Divisekara/Digital-Line-Follower-PIC16F877A/lab project files/project report/IMG-20181125-WA0025.jpg

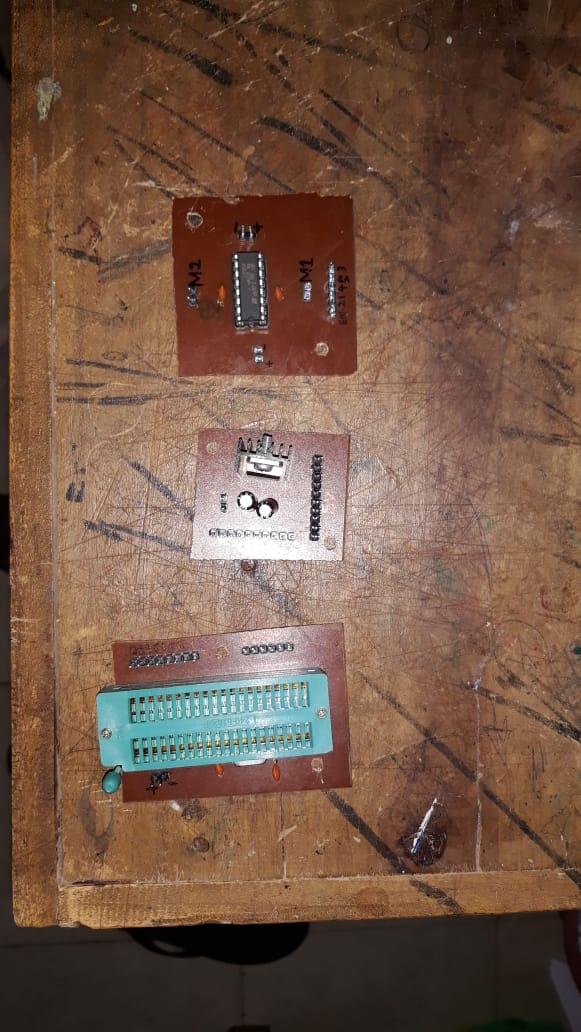
lab project files/project report/IMG-20181125-WA0025.jpg
