Divisekara/Digital-Line-Follower-PIC16F877A/lab project files/project report/IMG-20181129-WA0038.jpg

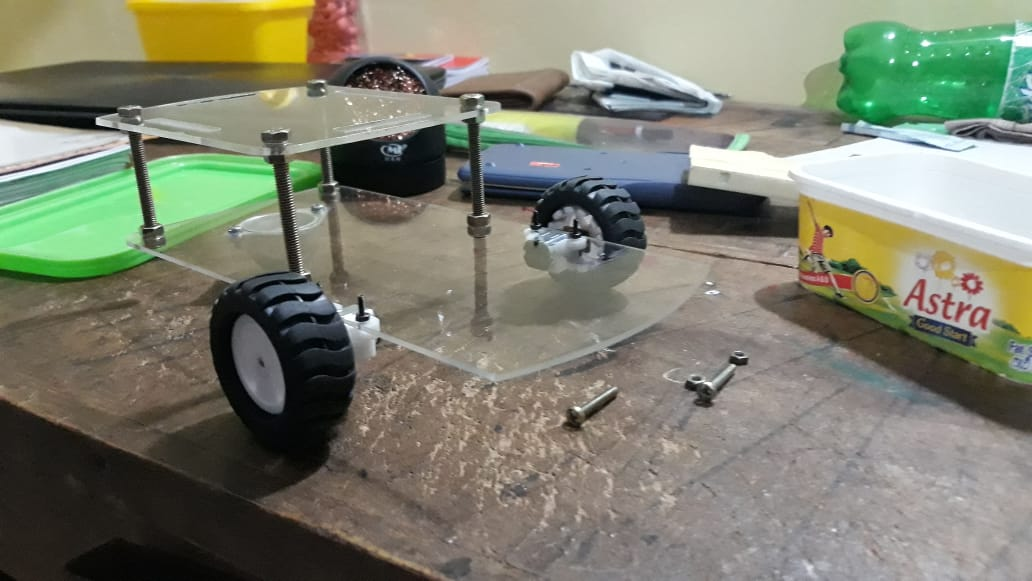
lab project files/project report/IMG-20181129-WA0038.jpg
