Divisekara/Digital-Line-Follower-PIC16F877A/README.md

# Digital Line Follower-PIC16F877A
 Digital Line follower was meade of as simple as possinle using custome made PCBs on our own.  Using micro C software we programmed the PIC16F877A.
