Divisekara/Digital-Line-Follower-PIC16F877A/lab report/Top part.pdf

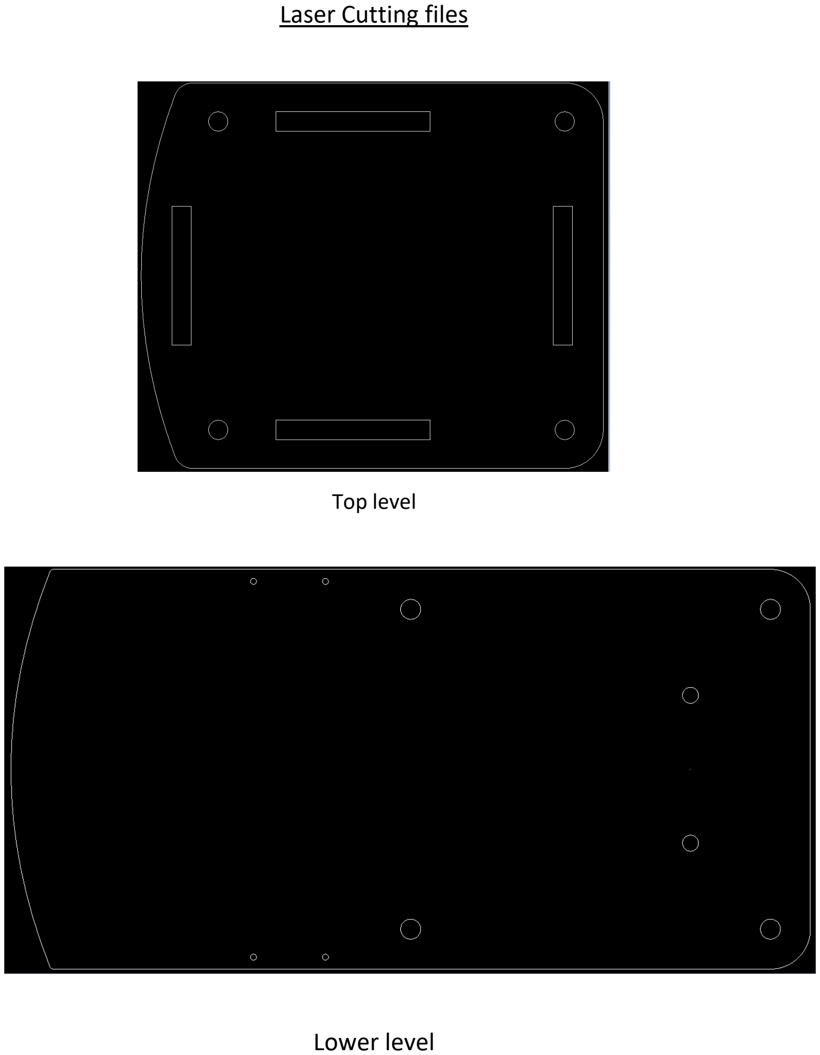
[picture p43: page 1]

Laser Cutting files

Top level

Lower level

Solidworks Designs

1. Lower Level

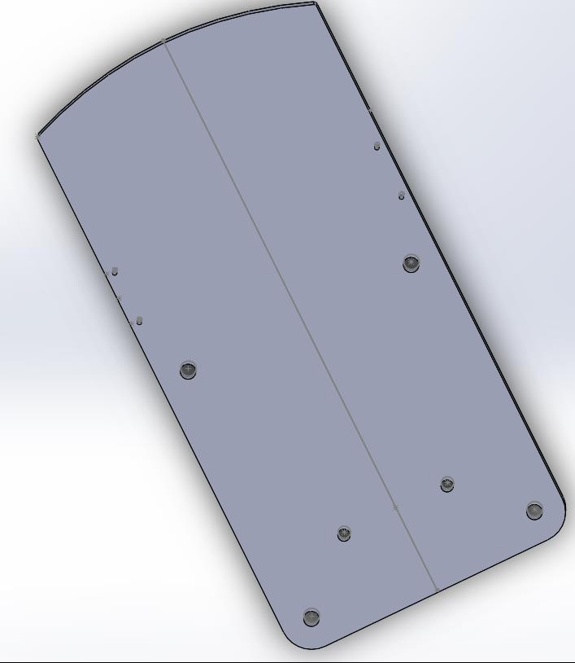
[picture p44: figure]

2. Top level

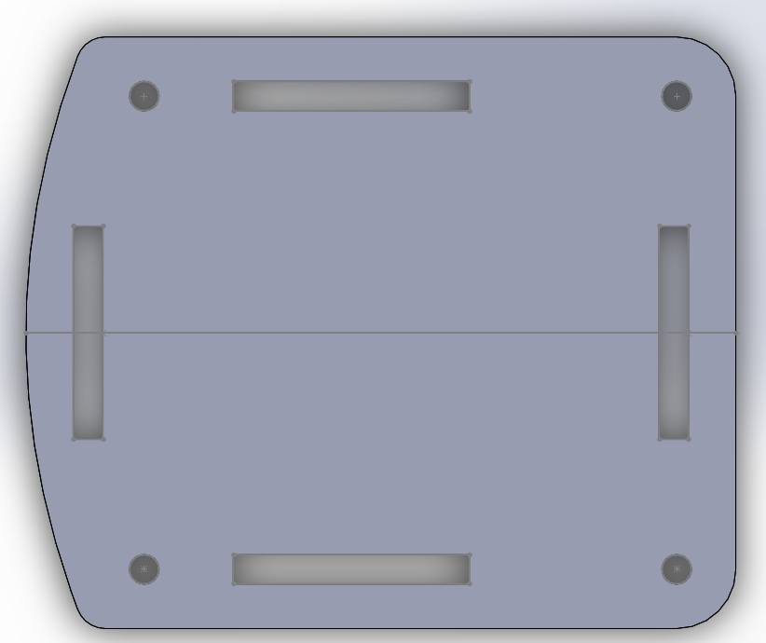
[picture p45: figure]
