Divisekara/Digital-Line-Follower-PIC16F877A/lab project files/weekly plan.pdf

### Team Members

Name | Index No
W.S.D. Fernando | 170168K | Mechanics and hardwork
D.M.D.P. Dissanayake | 170147V | Programming the PIC micro controller PCB designs
G. Gajanan | 170170J
D.M.A.I.Divisekara | 170150A

### Allocated work

Task
| 15 | 16 | 17 | 18 | 19 | 20 | 21 | 22 | 23 | 24 | 25 | 26 | 27 | 28 | 29 | 30
Making the schematic diagrams | Sensors
| Motor controllers
| Micro controller and power supply
Designing the enclosure using solid works
Making the layouts of the pcb | Sensors
| Motor controllers
| Micro controller and power supply
Programming PIC
Making PCBs | Sensors
| Motor controllers
| Micro controller and power supply
Testing the PCBs | Sensors
| Motor controllers
| Micro controller and power supply
Making enclosure
Assembling Components
Testing

### WEEKLY PLAN

Week one | Week two
