Divisekara/Digital-Line-Follower-PIC16F877A/lab project files/waas,asitha.docx

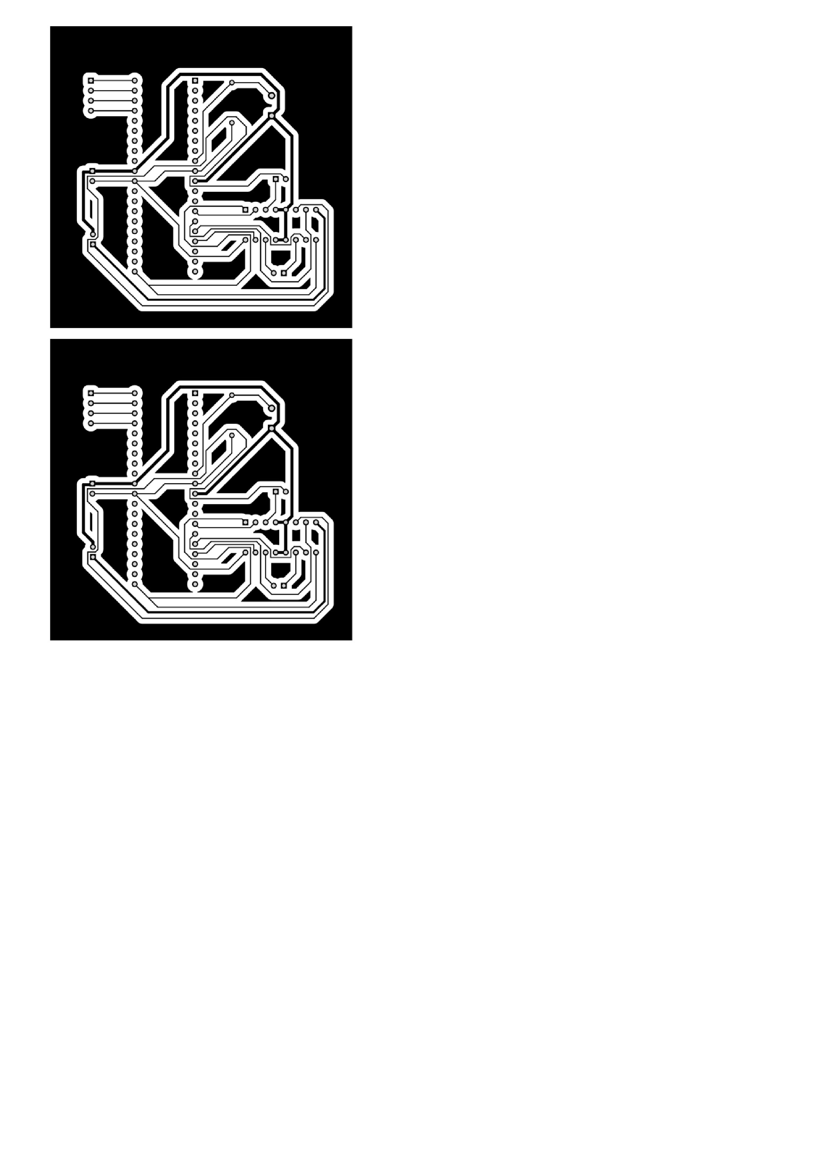
[picture p46: figure]
