Divisekara/Digital-Line-Follower-PIC16F877A/lab project files/LAST LAYOUTS/all layouts.docx

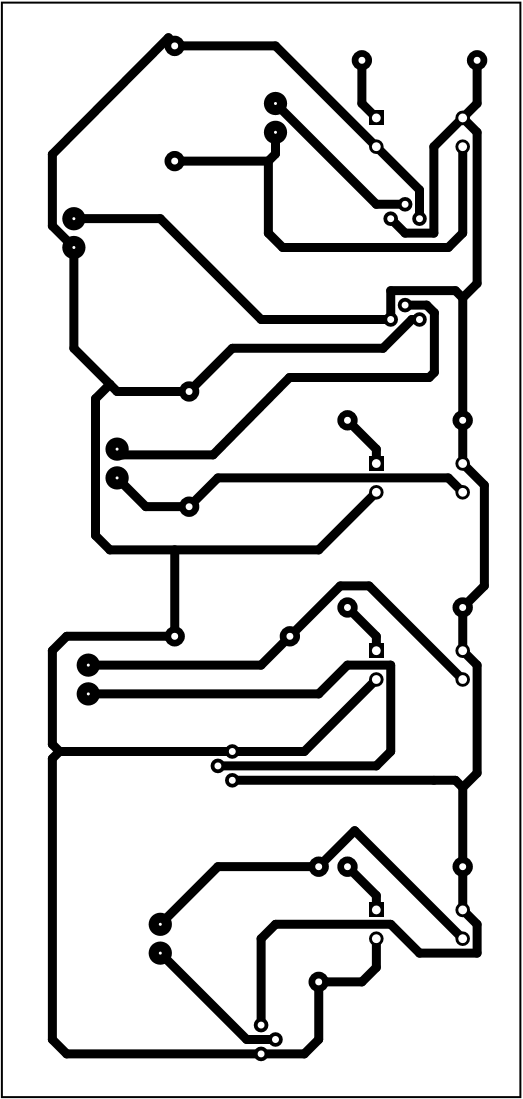
[picture p47: figure]
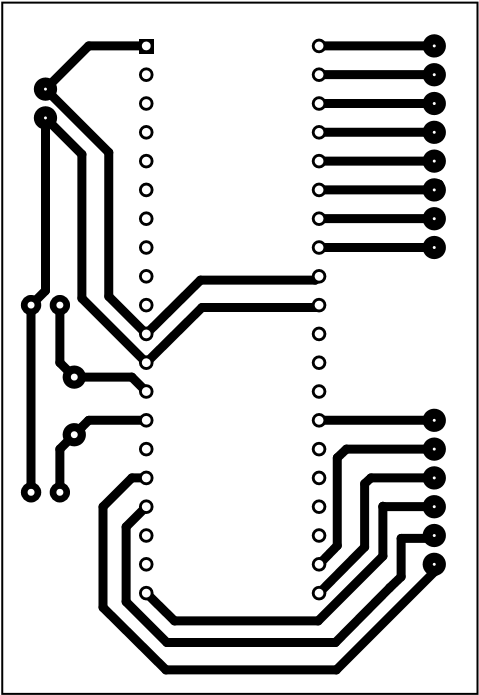
[picture p48: figure]
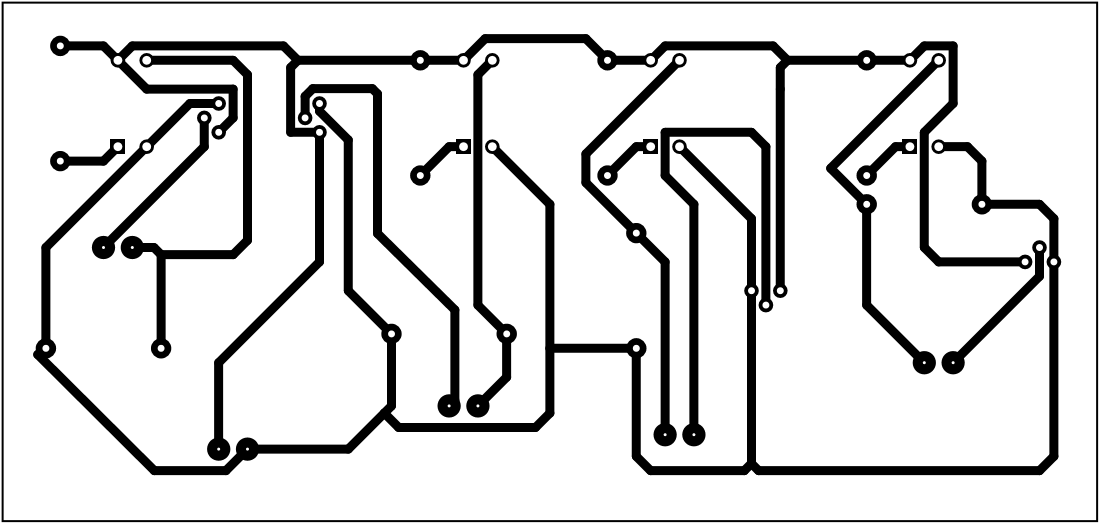
[picture p49: figure]
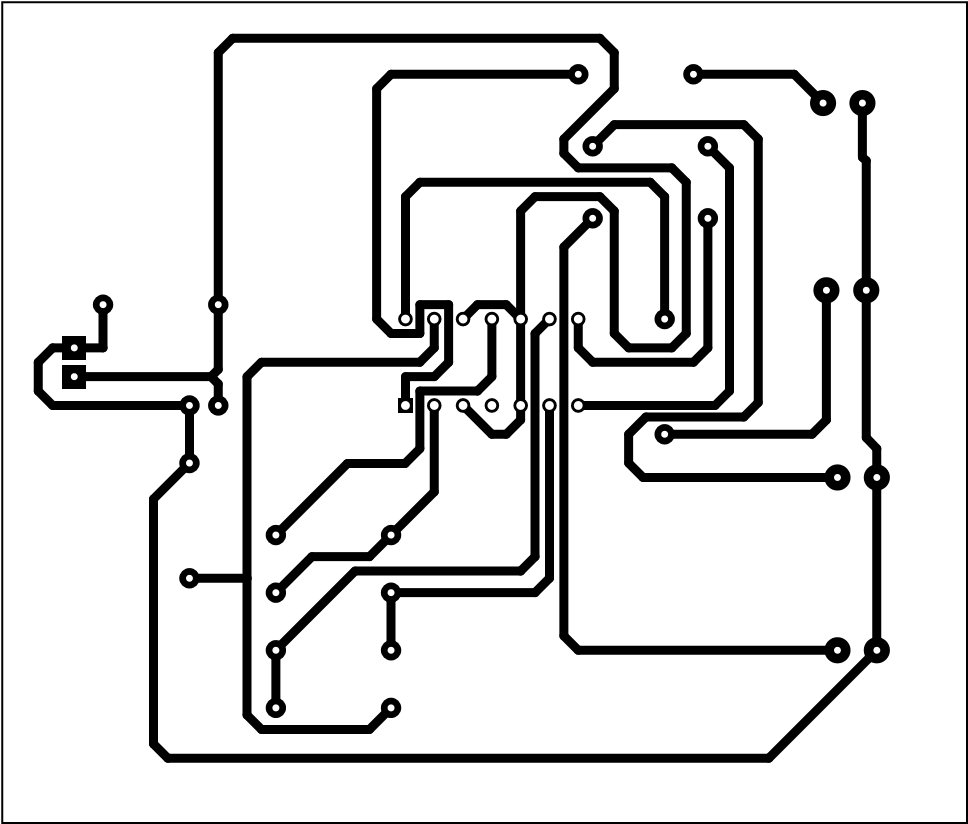
[picture p50: figure]

v
