Divisekara/Digital-Line-Follower-PIC16F877A/lab project files/layout new.pdf

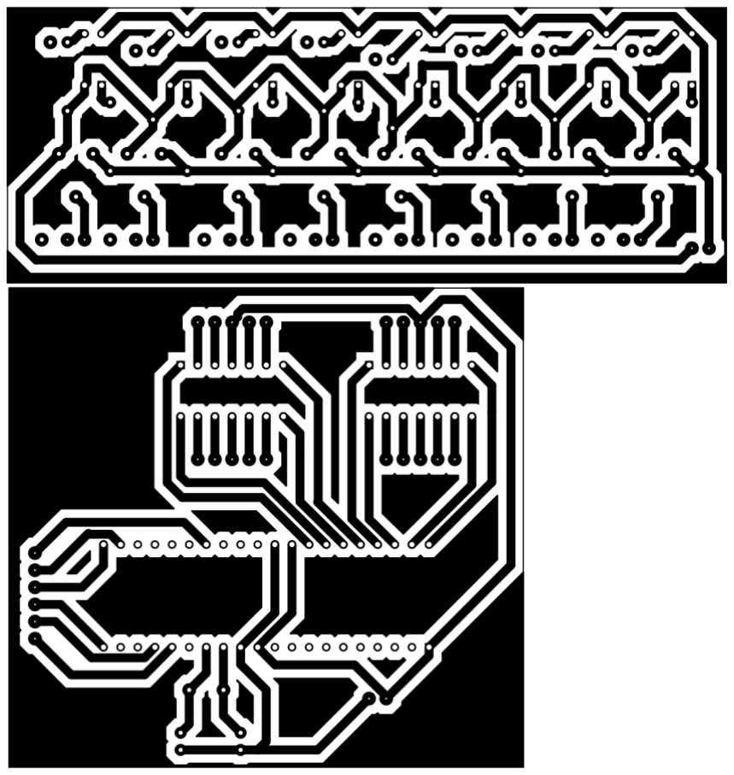
[picture p51: figure]
