Divisekara/Digital-Line-Follower-PIC16F877A/lab project files/pcb project.pdf

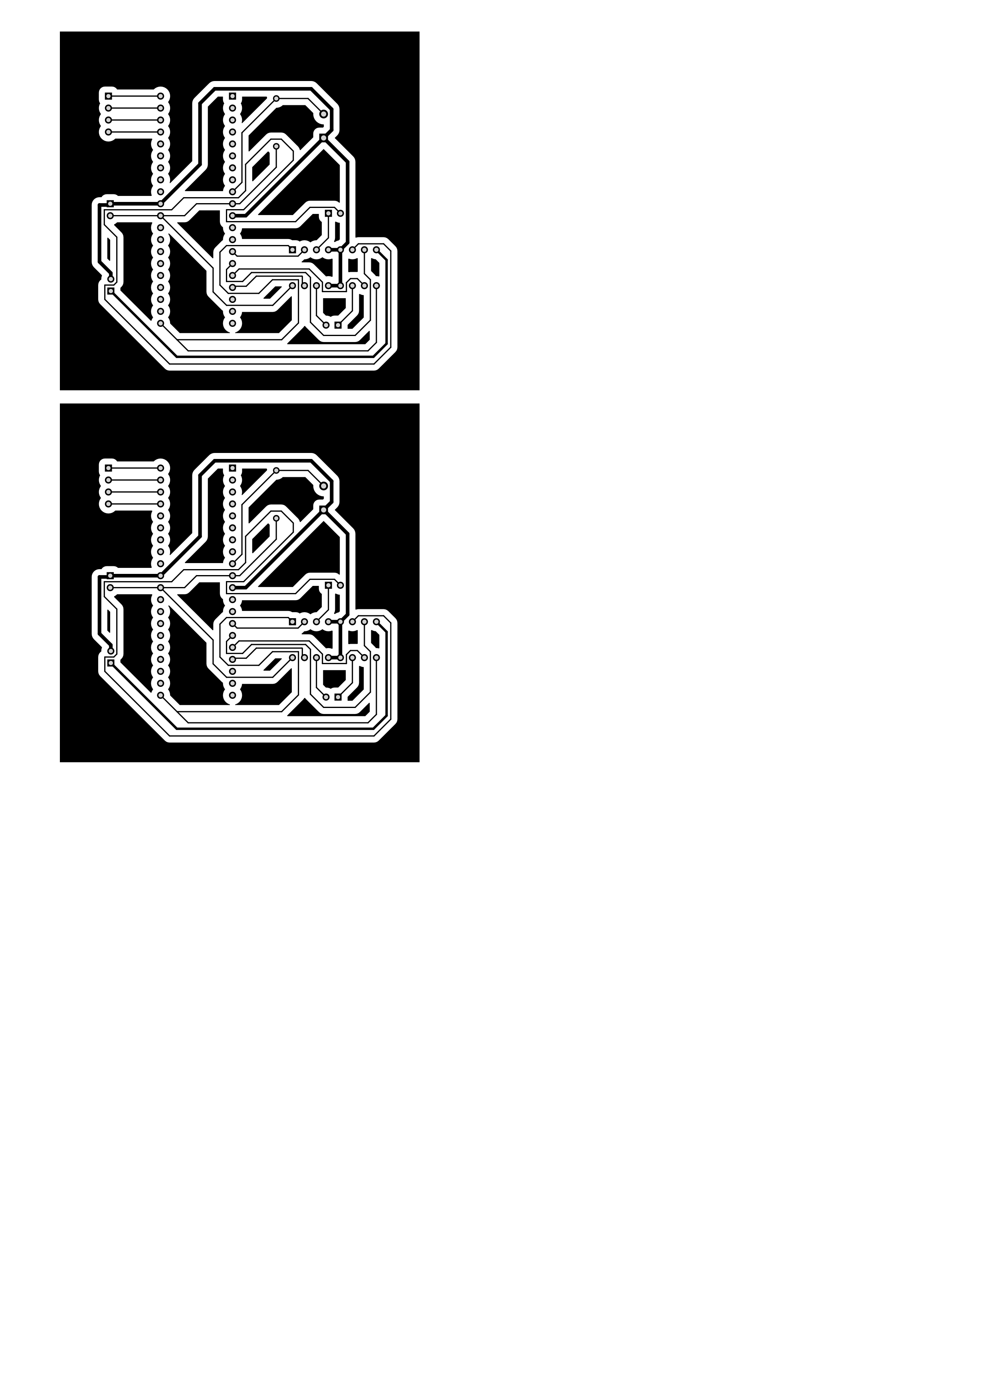
[picture p52: page 1]
