Divisekara/Digital-Line-Follower-PIC16F877A/lab project files/Line-Follower-Robot-using-PIC-Microcontroller-circuit-diagram (2).png

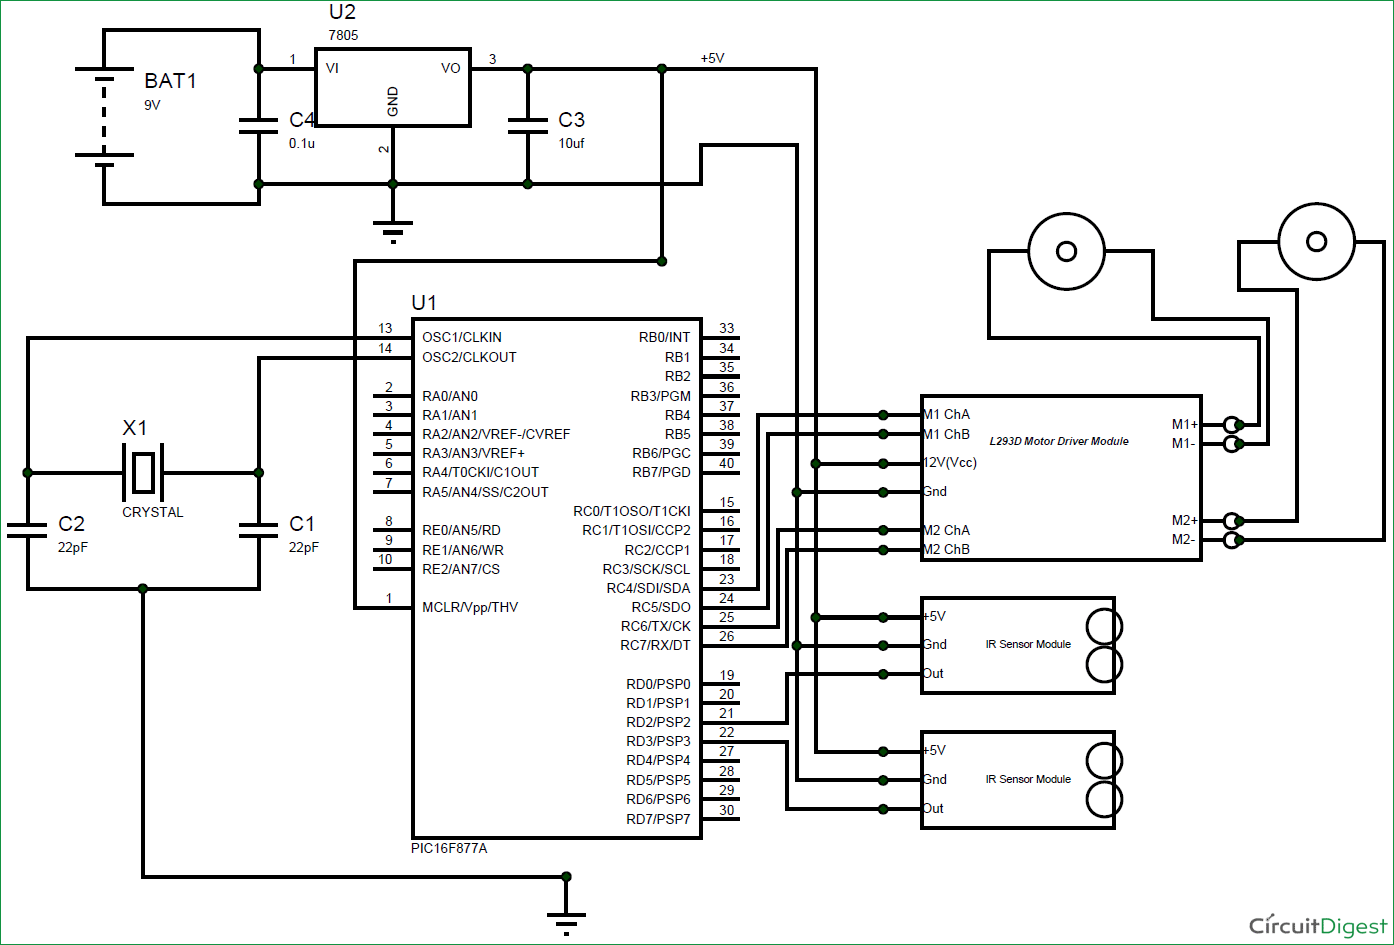
lab project files/Line-Follower-Robot-using-PIC-Microcontroller-circuit-diagram (2).png
