Divisekara/Digital-Line-Follower-PIC16F877A/lab project files/PIC.JPG

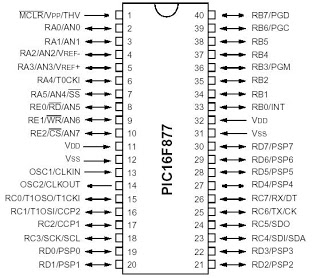
lab project files/PIC.JPG
