Divisekara/Digital-Line-Follower-PIC16F877A/lab project files/project report/IMG-20181124-WA0017.jpg

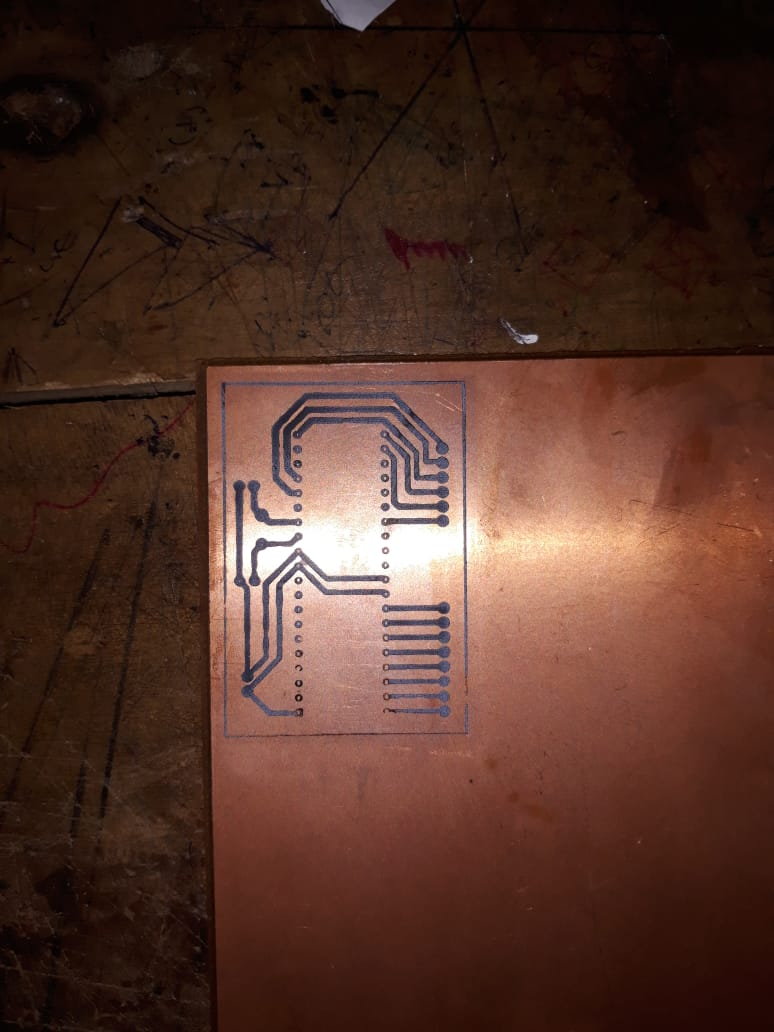
lab project files/project report/IMG-20181124-WA0017.jpg
