Divisekara/Digital-Line-Follower-PIC16F877A/lab project files/project report/IMG-20181129-WA0040.jpg

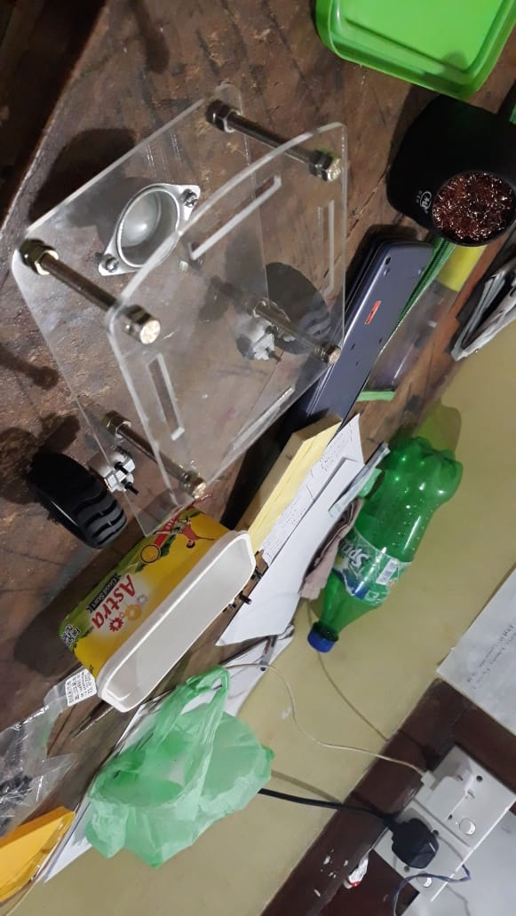
lab project files/project report/IMG-20181129-WA0040.jpg
