Divisekara/Digital-Line-Follower-PIC16F877A/lab project files/chasis1.SLDPRT

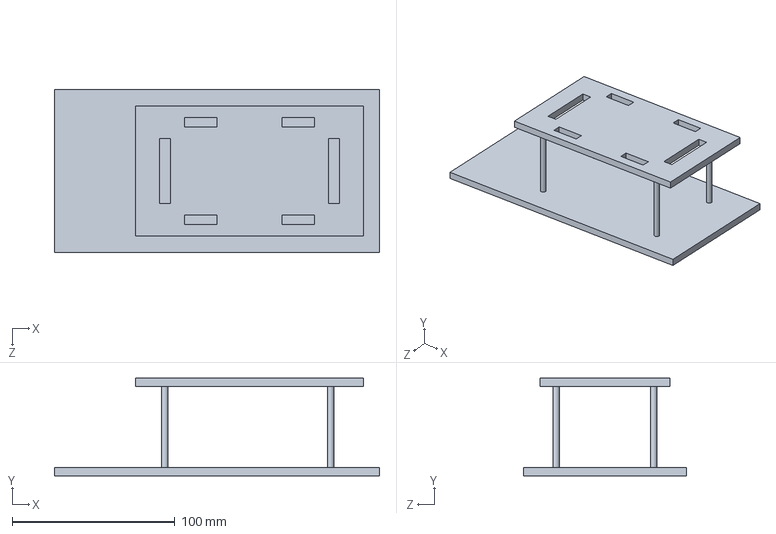
[picture p57: CAD file, 2020-08-01]
lab project files/chasis1.SLDPRT
200.0 x 60.0 x 100.0 mm
