Divisekara/Digital-Line-Follower-PIC16F877A/(list of files, cad)

Other CAD files:
MPLABXProjects/final code.X/dist/default/production/final_code.X.production.obj
MPLABXProjects/FINAL2.X/dist/default/production/FINAL2.X.production.obj
MPLABXProjects/final3.X/dist/default/production/final3.X.production.obj
MPLABXProjects/led blink.X/dist/default/production/led_blink.X.production.obj
MPLABXProjects/line follower1.X/dist/default/production/line_follower1.X.production.obj
MPLABXProjects/wheels.X/dist/default/production/wheels.X.production.obj
