Divisekara/Digital-Line-Follower-PIC16F877A/lab project files/sensor layout.pdf

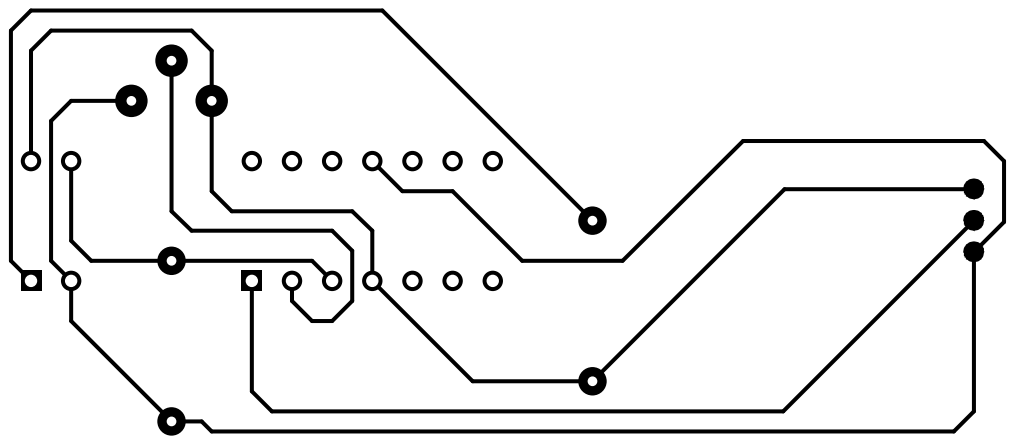
[picture p58: page 1]
