Divisekara/Digital-Line-Follower-PIC16F877A/lab project files/sensor layout2.pdf

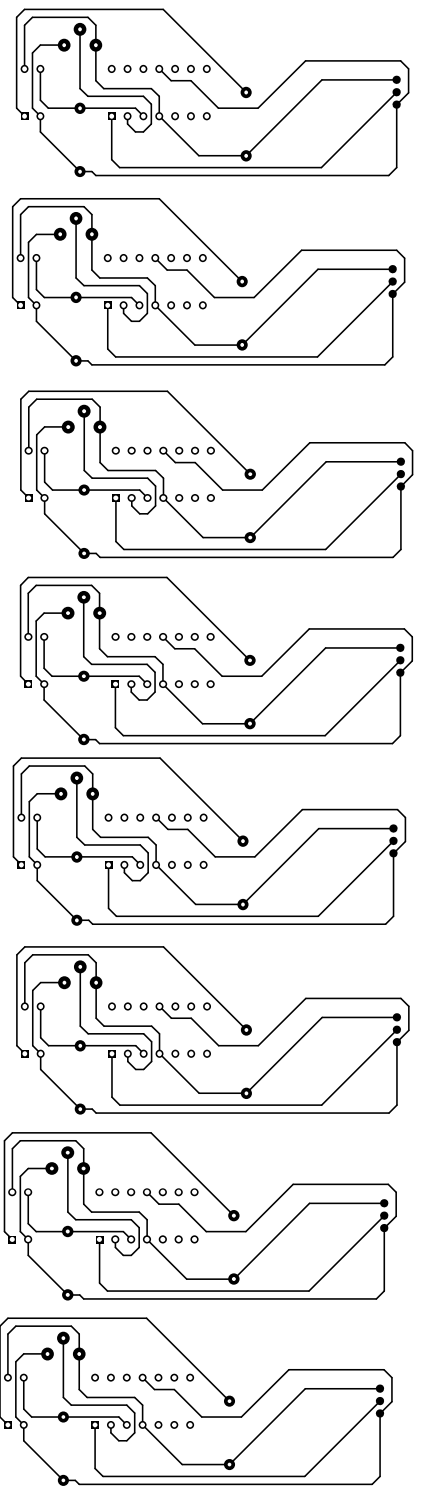
[picture p59: page 1]
