Divisekara/Digital-Line-Follower-PIC16F877A/lab project files/LAST LAYOUTS/all layouts.pdf

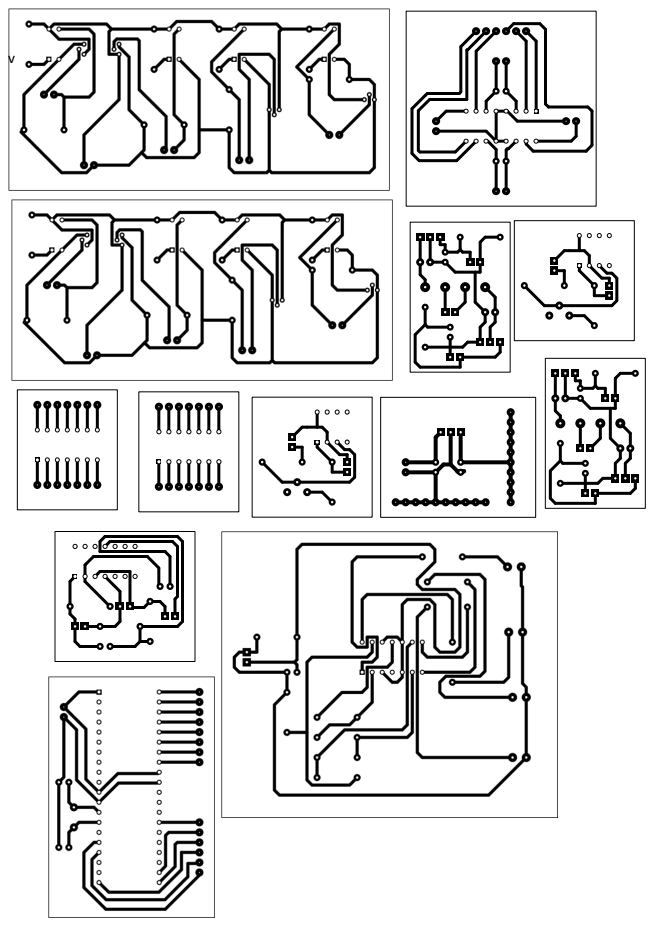
[picture p60: page 1]
