Divisekara/Digital-Line-Follower-PIC16F877A/lab project files/LAST LAYOUTS/all layouts2.pdf

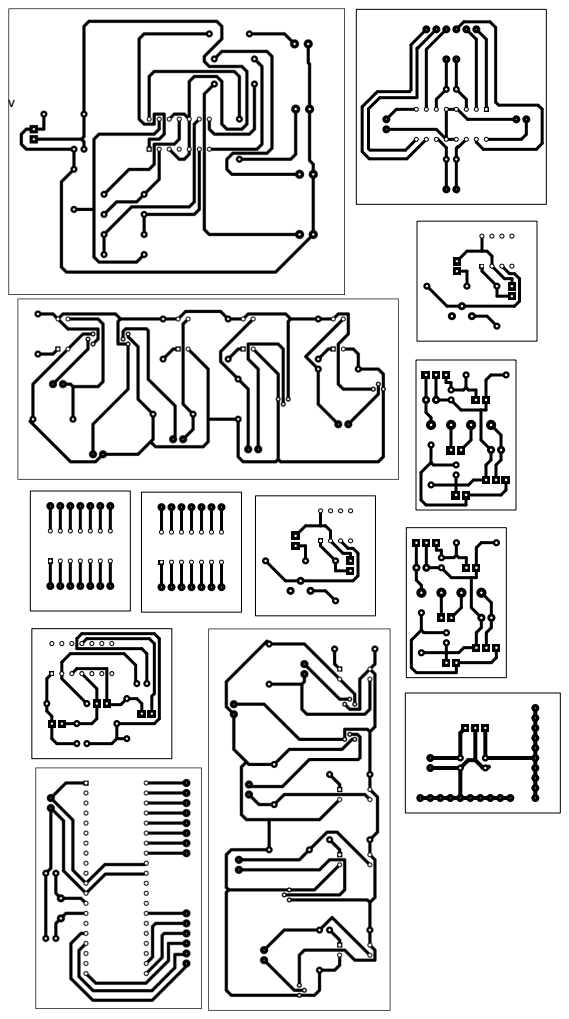
[picture p61: page 1]
