Divisekara/Digital-Line-Follower-PIC16F877A/lab project files/main circuit proteus/Main Circuit_1.pdf

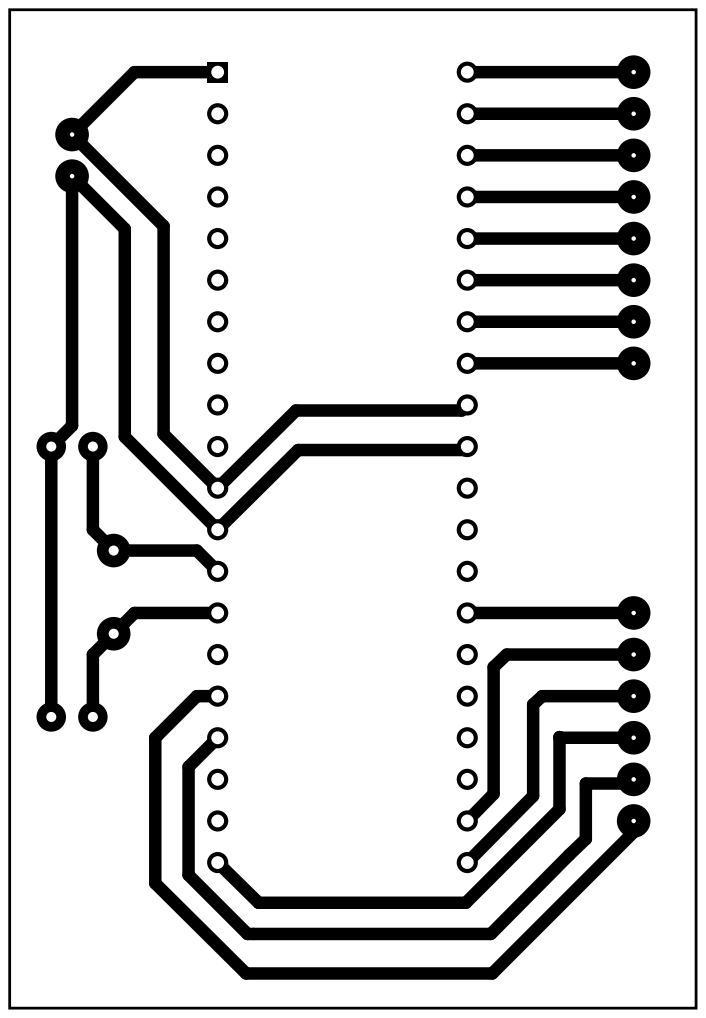
[picture p62: page 1]
