Divisekara/Digital-Line-Follower-PIC16F877A/lab project files/motor proteus/motor proteus_2.pdf

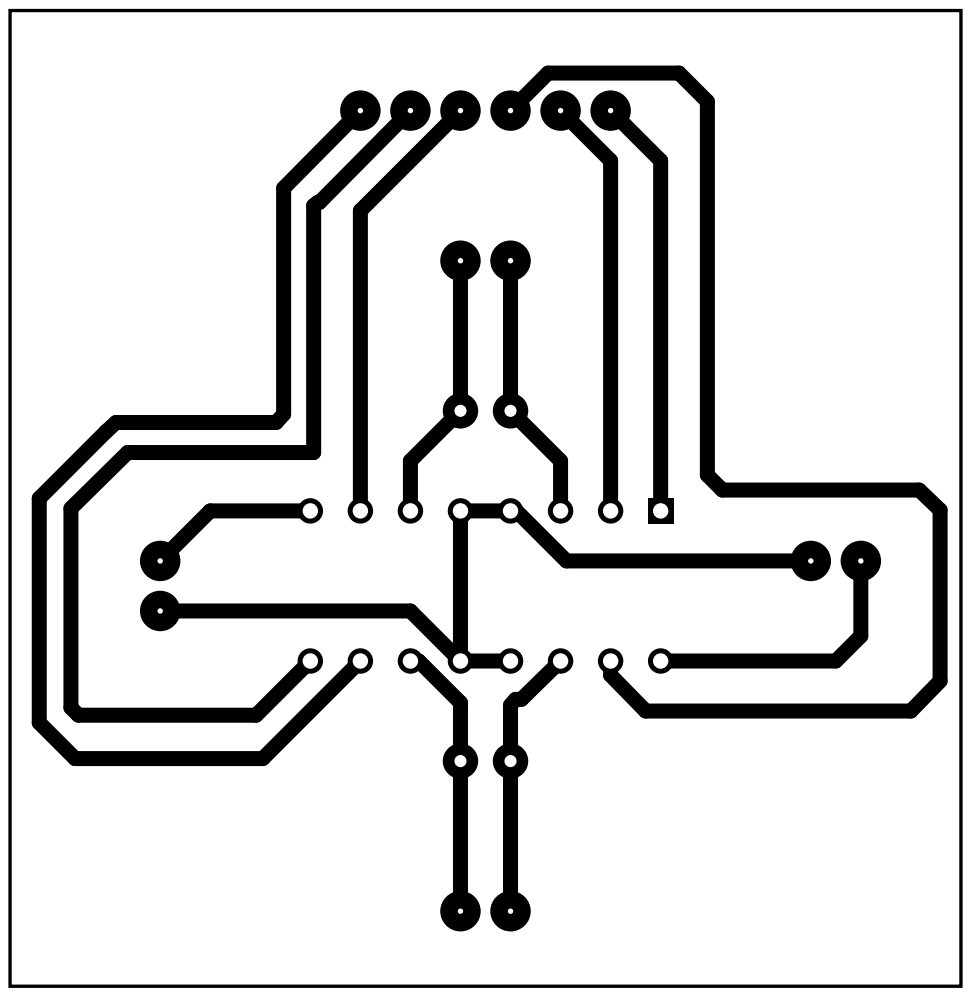
[picture p63: page 1]
