Divisekara/Digital-Line-Follower-PIC16F877A/lab project files/motor proteus/motor_layout1.pdf

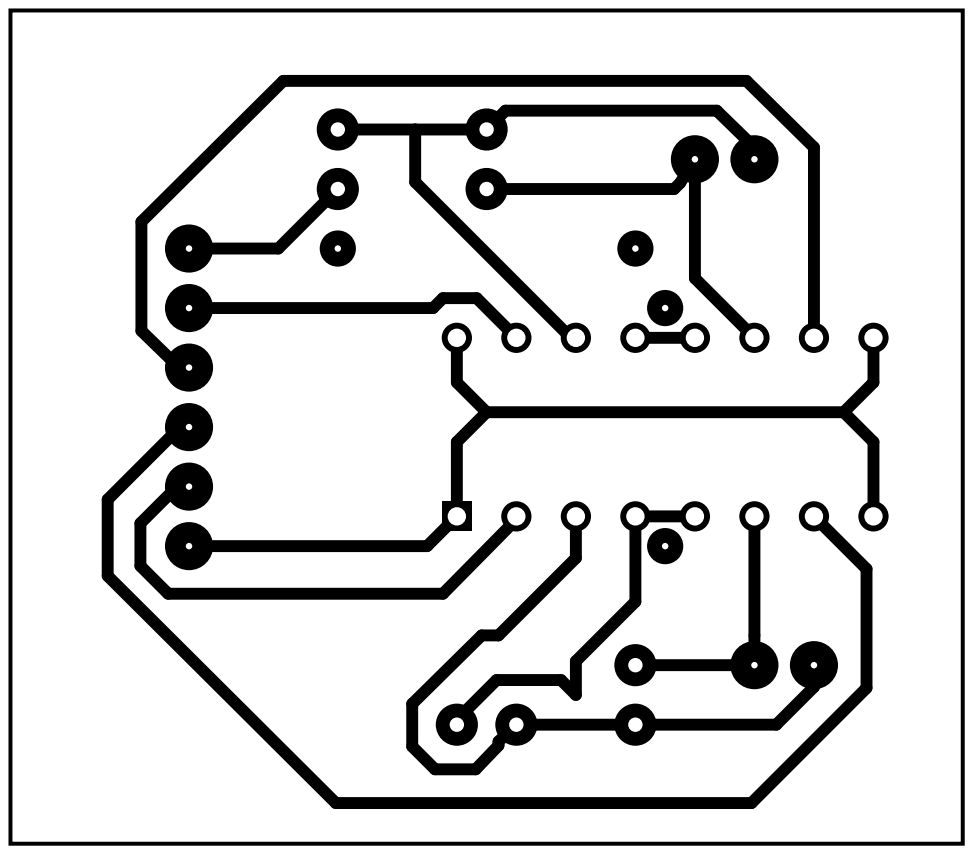
[picture p64: page 1]
