Divisekara/Digital-Line-Follower-PIC16F877A/lab project files/power supply/POWER_SUPPLY2.pdf

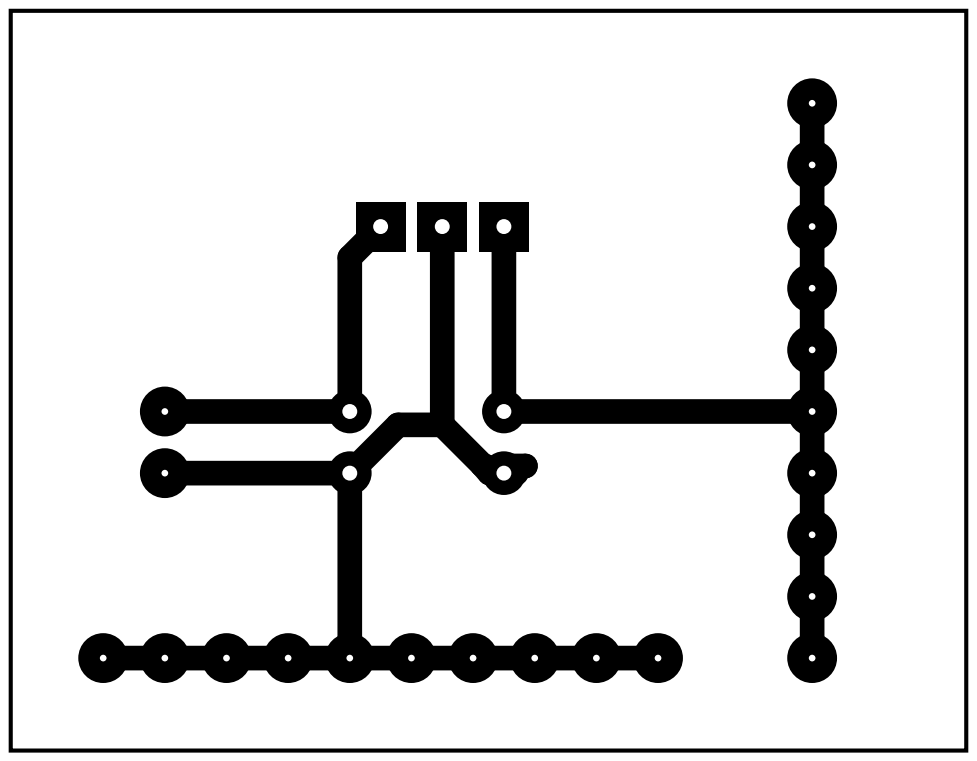
[picture p65: page 1]
