Divisekara/Digital-Line-Follower-PIC16F877A/lab project files/sensor proteus/sensor layout 2.pdf

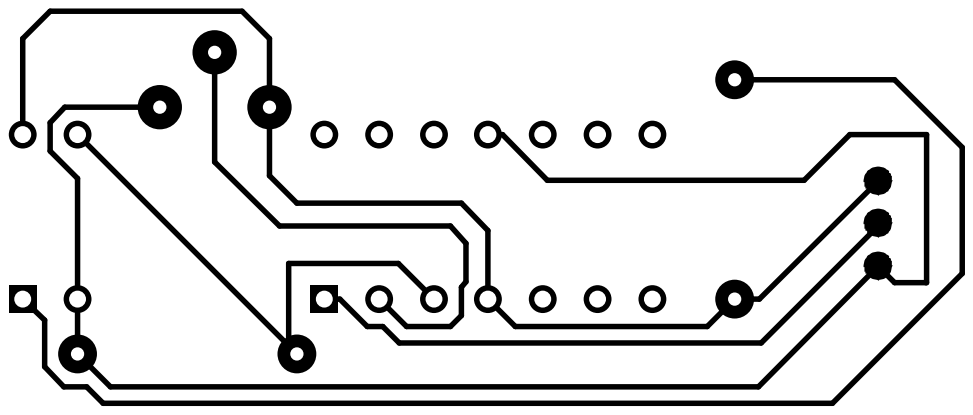
[picture p66: page 1]
