Divisekara/Digital-Line-Follower-PIC16F877A/lab project files/sensor proteus/sensor layout 3.pdf

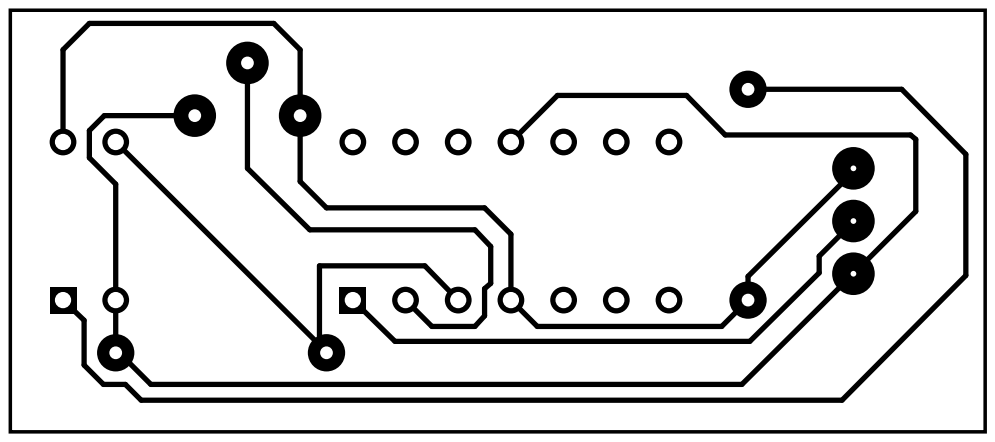
[picture p67: page 1]
