Divisekara/Digital-Line-Follower-PIC16F877A/lab project files/sensor proteus/sensor layout4.pdf

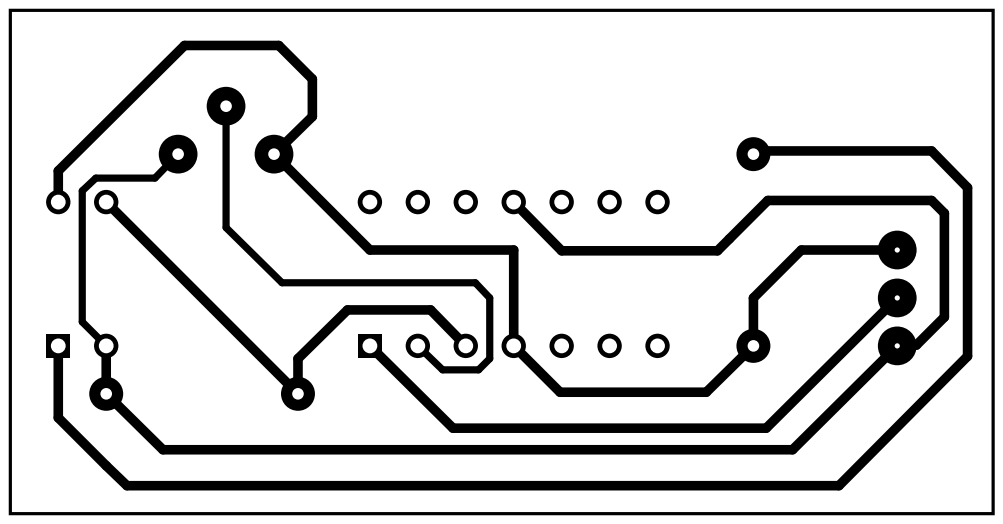
[picture p68: page 1]
