Divisekara/Digital-Line-Follower-PIC16F877A/lab project files/LAST LAYOUTS/lab project/last layouts1.pdf

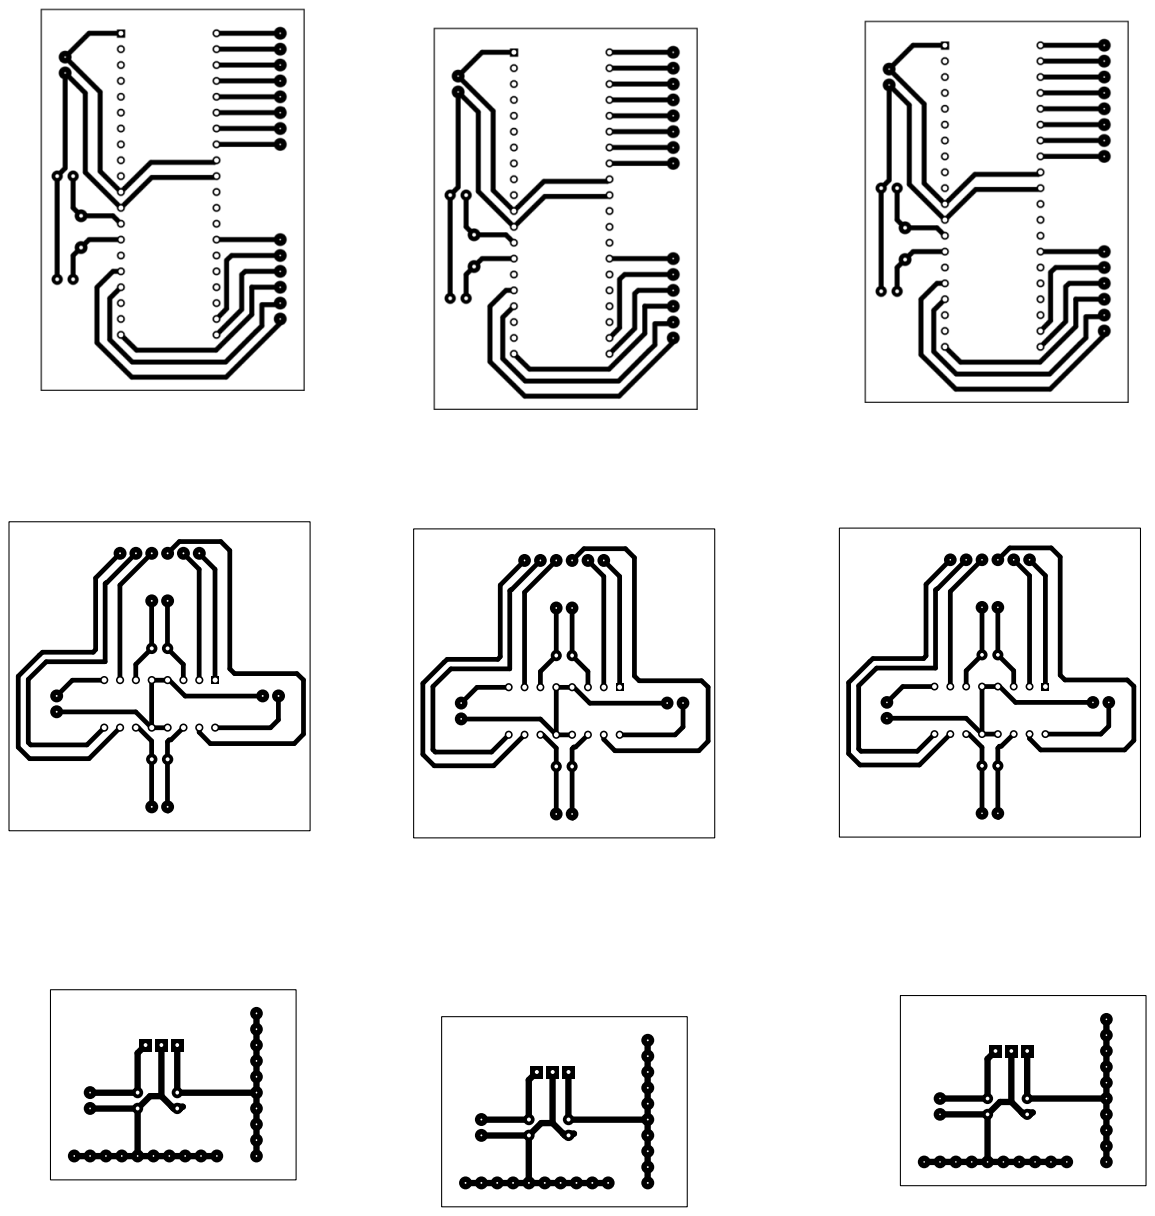
[picture p69: page 1]
