Divisekara/Digital-Line-Follower-PIC16F877A/lab project files/LAST LAYOUTS/lab project/lm324.pdf

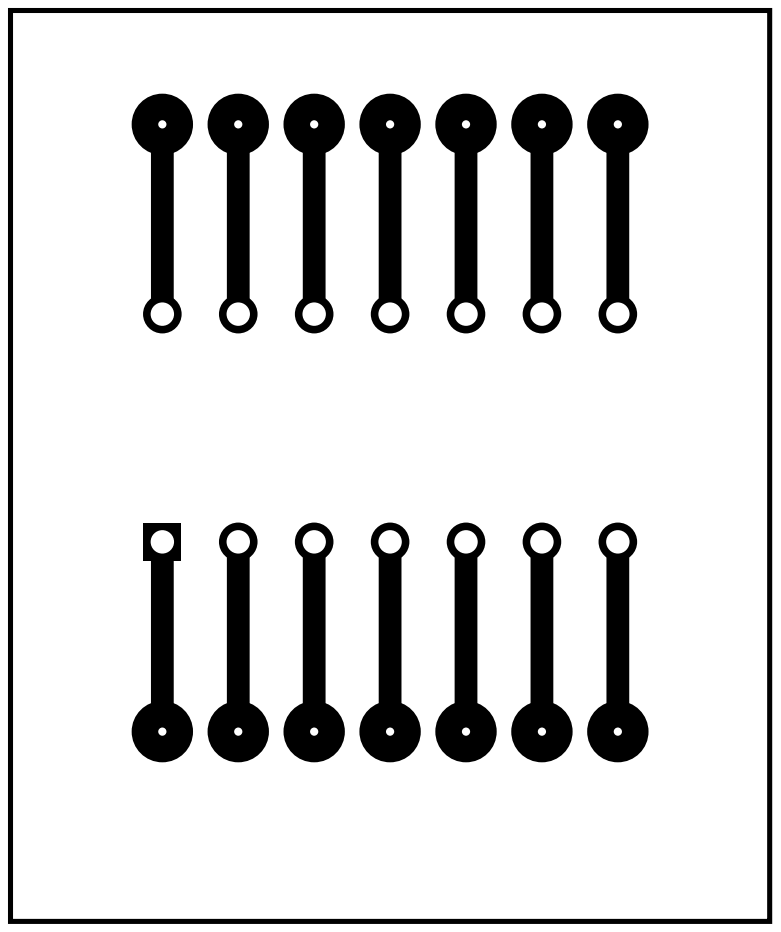
[picture p70: page 1]
