Divisekara/Digital-Line-Follower-PIC16F877A/lab project files/LAST LAYOUTS/lab project/sensor 4 channel 2.pdf

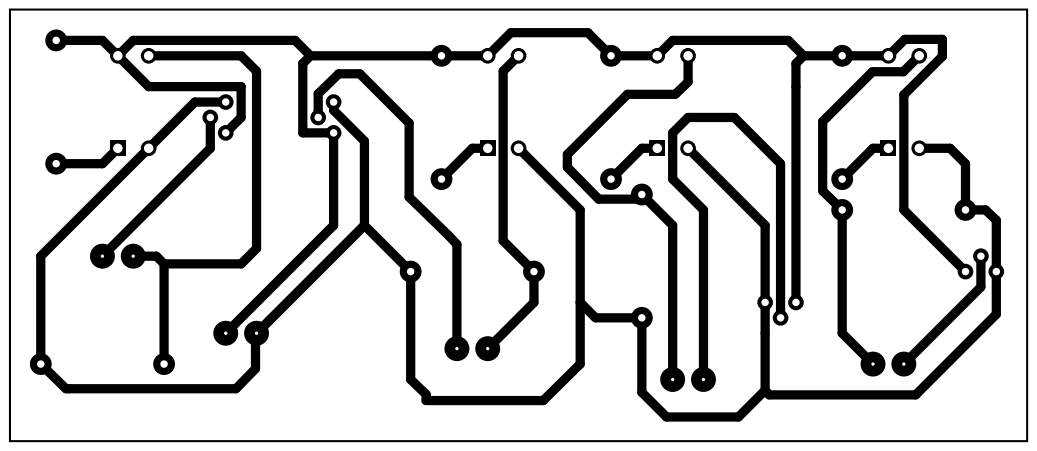
[picture p71: page 1]
