Divisekara/Digital-Line-Follower-PIC16F877A/lab project files/LAST LAYOUTS/lab project/sensor 4 channel.pdf

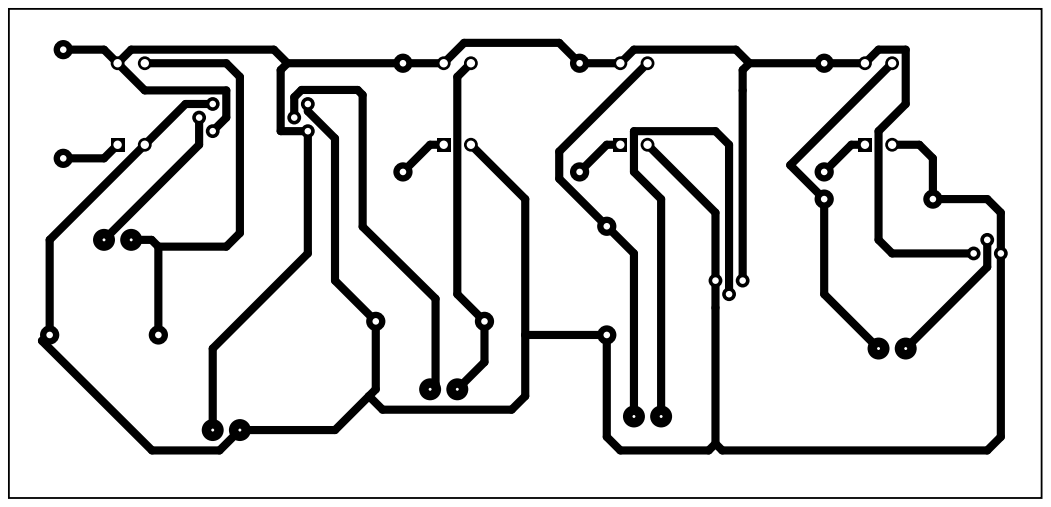
[picture p72: page 1]
