Divisekara/Digital-Line-Follower-PIC16F877A/(list of files, drawings)

Other design files:
lab project files/lm324.pdsprj
lab project files/lm324/lm324.pdsprj
lab project files/main circuit proteus/pic.pdsprj
lab project files/motor proteus/motors2.pdsprj
lab project files/motor proteus/motors3.pdsprj
lab project files/new pcbs/SENSOR_8_CHANNEL ori last.pdsprj
lab project files/pic (2).pdsprj
lab project files/pic.pdsprj
lab project files/power supply/power supply.pdsprj
lab project files/power supply/SENSOR_8_CHANNEL ori last.pdsprj
lab project files/sensor proteus/lm324.pdsprj
lab project files/sensor proteus/sensor.pdsprj
lab project files/sensor proteus/SENSOR_8_CHANNEL ori.pdsprj
lab project files/sensor proteus/SENSOR_8_CHANNEL.pdsprj
lab project files/SENSOR_8_CHANNEL ori last.pdsprj
lab project files/sensor_circuit.pdsprj
